silvamafalda966-svg/Strawberry_car/Core/Src/main.c

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
/* Includes ------------------------------------------------------------------*/
#include "main.h"
#include "cmsis_os.h"
#include "i2c.h"
#include "tim.h"
#include "usart.h"
#include "gpio.h"

/* USER CODE BEGIN Includes */
#include "bsp_motor.h"
#include "pid.h"
#include "chassis.h"
/* USER CODE END Includes */


/* USER CODE BEGIN PV */
extern uint8_t rx_byte;    // USART1 RX byte
extern uint8_t rx_byte_bt; // UART4 蓝牙 RX byte

/* USER CODE END PV */

void SystemClock_Config(void);
void MX_FREERTOS_Init(void);
/**
  * @brief  The application entry point.
  * @retval int
  */
int main(void)
{

  /* MCU Configuration--------------------------------------------------------*/

  /* Reset of all peripherals, Initializes the Flash interface and the Systick. */
  HAL_Init();

  /* Configure the system clock */
  SystemClock_Config();

  /* Initialize all configured peripherals */
  MX_GPIO_Init();
  MX_I2C1_Init();
  MX_I2C2_Init();
  MX_TIM1_Init();
  MX_TIM2_Init();
  MX_TIM3_Init();
  MX_TIM4_Init();
  MX_TIM5_Init();
  MX_TIM9_Init();
  MX_USART2_UART_Init();
  MX_TIM8_Init();
  MX_TIM6_Init();
  MX_USART1_UART_Init();
  MX_UART4_UART_Init();   // 蓝牙 RX (PC11)
  MX_UART5_UART_Init();   // 蓝牙 TX (PC12)
  /* USER CODE BEGIN 2 */

  // 1. 唤醒 PWM 动力系统
  Motor_Init();
  PID_Init();
  Chassis_Init();
  // 2. 唤醒 四路编码器测速系统
  HAL_TIM_Encoder_Start(&htim5, TIM_CHANNEL_ALL); // 左前 (FL)
  HAL_TIM_Encoder_Start(&htim4, TIM_CHANNEL_ALL); // 左后 (BL)
  HAL_TIM_Encoder_Start(&htim2, TIM_CHANNEL_ALL); // 右前 (FR)
  HAL_TIM_Encoder_Start(&htim8, TIM_CHANNEL_ALL); // 右后 (BR)
HAL_UART_Receive_IT(&huart1, &rx_byte, 1); // USART1 = VOFA+ USB 调试指令通道
HAL_UART_Receive_IT(&huart4, &rx_byte_bt, 1); // UART4 = 蓝牙指令通道
  /* USER CODE END 2 */

  /* Call init function for freertos objects (in cmsis_os2.c) */
  MX_FREERTOS_Init();

  /* Start scheduler */
  osKernelStart();

  /* We should never get here as control is now taken by the scheduler */

  /* Infinite loop */
  /* USER CODE BEGIN WHILE */
  
  while (1)
  {
    /* USER CODE END WHILE */

    /* USER CODE BEGIN 3 */
  }
  /* USER CODE END 3 */
}

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
/**
  * @brief  Period elapsed callback in non blocking mode
  * @note   This function is called  when TIM7 interrupt took place, inside
  * HAL_TIM_IRQHandler(). It makes a direct call to HAL_IncTick() to increment
  * a global variable "uwTick" used as application time base.
  * @param  htim : TIM handle
  * @retval None
  */
void HAL_TIM_PeriodElapsedCallback(TIM_HandleTypeDef *htim)
{
  if (htim->Instance == TIM7)
  {
    HAL_IncTick();
  }
}

/**
  * @brief  This function is executed in case of error occurrence.
  * @retval None
  */
void Error_Handler(void)
{
  /* USER CODE BEGIN Error_Handler_Debug */
  /* User can add his own implementation to report the HAL error return state */
  __disable_irq();
  while (1)
  {
  }
  /* USER CODE END Error_Handler_Debug */
}
#ifdef USE_FULL_ASSERT
/**
  * @brief  Reports the name of the source file and the source line number
  *         where the assert_param error has occurred.
  * @param  file: pointer to the source file name
  * @param  line: assert_param error line source number
  * @retval None
  */
void assert_failed(uint8_t *file, uint32_t line)
{
  /* USER CODE BEGIN 6 */
  /* User can add his own implementation to report the file name and line number,
     ex: printf("Wrong parameters value: file %s on line %d\r\n", file, line) */
  /* USER CODE END 6 */
}
#endif /* USE_FULL_ASSERT */
