silvamafalda966-svg/Strawberry_car/BSP/Inc/oledfont.h

#ifndef __OLEDFONT_H
#define __OLEDFONT_H

/* ── 中文计数（extern 声明也需要，放最前面） ── */
#define HZK16_COUNT 34

#ifdef OLEDFONT_DEFINE
/* ═════════════════════════════════════════════════
   以下为实际数据定义，仅 oled.c (定义 OLEDFONT_DEFINE) 编译
   ═════════════════════════════════════════════════ */

/* 6x8 ASCII font */
const unsigned char asc2_0806[][6] = {
    {0x00,0x00,0x00,0x00,0x00,0x00},// sp
    {0x00,0x00,0x00,0x2F,0x00,0x00},// !
    {0x00,0x00,0x07,0x00,0x07,0x00},// q2
    {0x00,0x14,0x7F,0x14,0x7F,0x14},// #
    {0x00,0x24,0x2A,0x7F,0x2A,0x12},// $
    {0x00,0x62,0x64,0x08,0x13,0x23},// %
    {0x00,0x36,0x49,0x55,0x22,0x50},// &
    {0x00,0x00,0x05,0x03,0x00,0x00},// '
    {0x00,0x00,0x1C,0x22,0x41,0x00},// (
    {0x00,0x00,0x41,0x22,0x1C,0x00},// )
    {0x00,0x14,0x08,0x3E,0x08,0x14},// *
    {0x00,0x08,0x08,0x3E,0x08,0x08},// +
    {0x00,0x00,0x00,0xA0,0x60,0x00},// ,
    {0x00,0x08,0x08,0x08,0x08,0x08},// -
    {0x00,0x00,0x60,0x60,0x00,0x00},// .
    {0x00,0x20,0x10,0x08,0x04,0x02},// /
    {0x00,0x3E,0x51,0x49,0x45,0x3E},// 0
    {0x00,0x00,0x42,0x7F,0x40,0x00},// 1
    {0x00,0x42,0x61,0x51,0x49,0x46},// 2
    {0x00,0x21,0x41,0x45,0x4B,0x31},// 3
    {0x00,0x18,0x14,0x12,0x7F,0x10},// 4
    {0x00,0x27,0x45,0x45,0x45,0x39},// 5
    {0x00,0x3C,0x4A,0x49,0x49,0x30},// 6
    {0x00,0x01,0x71,0x09,0x05,0x03},// 7
    {0x00,0x36,0x49,0x49,0x49,0x36},// 8
    {0x00,0x06,0x49,0x49,0x29,0x1E},// 9
    {0x00,0x00,0x36,0x36,0x00,0x00},// :
    {0x00,0x00,0x56,0x36,0x00,0x00},// ;
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
    HZK_22,  /* 速 */
    HZK_23,  /* 度 */
    HZK_24,  /* 已 */
    HZK_25,  /* 连 */
    HZK_26,  /* 未 */
    HZK_27,  /* 失 */
    HZK_28,  /* 败 */
    HZK_29,  /* 扫 */
    HZK_30,  /* 描 */
    HZK_31,  /* 区 */
    HZK_32,  /* 域 */
    HZK_33,  /* 熟 */
};

#endif /* __OLEDFONT_H */
