silvamafalda966-svg/Strawberry_car/(commit log)

2026-05-29 Initial commit: Day 1-2 baseline
    Four-wheel PID closed loop (Kp=0.35, Ki=0.06, Kd=0.04), encoder reading,
    K210 8-byte frame parser, VOFA+ USART1 debug, USART2 interrupt mode.
    Stall protection, speed ramp, parking lock strategy.
    Task_Sensor and Task_OLED are stubs.
2026-05-29 Phase 1: state machine skeleton + Chassis_Move API
    New files:
    - BSP/Inc/chassis.h: 10-state enum, SensorData_t, VisionData_t,
    StateDescriptor_t, 6 Chassis_Move API declarations, global variables
    - BSP/Src/chassis.c: descriptor table, Chassis_Move API implementations,
    VOFA+ M command parser, Chassis_Init(), state machine dispatcher.
    DEBUG state fully functional, IDLE state functional, 8 stubs with
    safe (Chassis_Stop) entries for Phase 2-4.
    Modified files:
    - freertos.c: main loop restructured (VOFA+ parse → encoder → vision
    queue → sensor mutex → emergency stop → state machine → PID×4 →
    VOFA+ upload). Task_Sensor implemented (IR read + emergency flag).
    K210 queue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
2026-05-29 Fix: add chassis.c to Keil project file
    Build error: L6218E undefined symbol for Chassis_Init, Chassis_Stop,
    Chassis_VOFA_Parse, Chassis_StateMachine_Run, g_chassis_state,
    g_emergency_stop — chassis.c was not in the project file.
2026-05-29 Fix: M command mapping (M0→IDLE, M1→LINE_FOLLOW, ..., M8→FINISH)
    Previously M0 mapped to STATE_DEBUG (enum=0), so hitting M0 while
    already in DEBUG was a no-op. Now matches the scheme document:
    MD→DEBUG, M0→IDLE, M1→LINE_FOLLOW, ..., M8→FINISH.
2026-05-29 Phase 1 fix: vision queue gate + LINE_FOLLOW entry cleanup
    - freertos.c: only read K210 queue when state is LINE_FOLLOW,
    BREAKAWAY, or VISUAL_APPROACH (not OBSTACLE/BLIND_RETURN etc.)
    - chassis.c entry_line_follow: MoveForward(0.3) + drain K210 queue
    to prevent stale frames triggering false detections
2026-06-02 Phase 2: 避障尾段重构 + BR PID调参 + 阶段间速度归零刹车
    - OB_TURN_ALIGN(90°)+OB_FIND_LINE(自旋) → OB_TURN_45(45°)+OB_FORWARD_TO_LINE(直行斜插上线)
    - 新增 TURN45_TOTAL_ENC/OB_FWD_TO_LINE_CM 宏
    - 阶段间刹车改为检测四轮 Actual 速度全部 <0.03m/s 才放行，最长等1s兜底
    - BR 右后轮 PID: Kp=0.75 Ki=0.07 Kd=0.01
2026-06-02 Phase 2 测试完成: 避障尾段优化 + 空转调试宏 + BR PID调参
    - 阶段间刹车改为检测四轮速度<0.03m/s放行，1s超时兜底
    - BR PID: Kp=0.55 Ki=0.05 Kd=0.05
    - 新增 ENABLE_ULTRASONIC 宏(空转测试时=0禁用超声波紧急刹车)
    - 新增 FORCE_STRAIGHT 宏(空转时=1强制LINE_FOLLOW纯直行，忽略悬空红外误读)
    - 根因定位: 红外悬空GPIO随机电平→LINE_FOLLOW误判线位置→不对称Target(0.45vs0.16)
    - VOFA+恢复原8通道格式(4轮速度+IR+黑点数+编码器+帧尾)
    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
2026-06-06 Day 6: 红外+超声波硬件接入完成
    - 八路红外巡线模块 IO 模式验证通过，PE0~PE7
    - HC-SR04 超声波改用 TIM3 CH4 输入捕获中断，零阻塞
    - 急停逻辑修复：距离>15cm 自动清零，仅 LINE_FOLLOW 触发
    - ENABLE_ULTRASONIC=1, FORCE_STRAIGHT=0 恢复正常模式
2026-06-11 Day 7: OLED SSD1315 I2C接入完成 - 中文字库+容错+蜂鸣心跳
2026-06-11 Day 7: 补充OLED驱动源文件(上一提交遗漏)
2026-06-11 Phase 3: v5草莓检测链完整实现 - 定长24B DMA+IDLE + 双轴伺服 + 固定窗口扫描
2026-06-13 feat: PID系统扫参 + BR前馈补偿 + EMA滤波 + 积分抗饱和
    三轮 PID: Kp=0.20 Ki=0.08 Kd=0.02 (超调0.9% 纹波0.0015)
    BR PID: Kp=0.35 Ki=0.08 Kd=0.10 + FF=40 (平台期95→35ms)
    EMA 滤波: α=0.3 四轮低通降噪
    积分抗饱和: 输出饱和时抑制同向I项蓄力
    F/L 命令: 运行时调前馈/滤波系数
    新增 tools/pid_tuner.py: 自动扫参脚本
2026-07-08 feat: V2 岔路采摘策略 + Zone Demo + 赛道实测参数校准
    - 状态机精简 15→10 状态（V1视觉链→V2岔路方案）
    - 黑胶带岔路检测：6路IR全黑×3帧消抖，十字标记
    - K210 多目标排序决策：红>绿，大>小，近>远
    - Zone Demo 全链路：Z:命令→编码器匹配→判定→返程
    - 赛道实测校准：ENC_PER_CM=2789, TURN90=199700, TURN180=399400
    - IR 传感器极性修正（TCRT5000+LM393 输出翻转）
    - 草莓区内侧策略（JUNCTION_SIDE=-1 左转进岔）
    - 避障参数实测调整（OB_BACK_CM=5, OB_FORWARD_CM=47）
    - 五指令文本协议集：S:/D:/C:/K:/Z:
    - OLED 中文字库扩展（区/域/熟）+ 区域信息面板
    - Bug修复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
2026-10-15 chore: 移除构建产物与内部文档，补全 .gitignore
    - 移除 6 个 Keil 构建产物（.axf/.hex/.map/.htm/.dep/.iex），仓库体积显著减小
    - 移除 docs/（答辩准备、交付交接、视频脚本等内部材料，不适合公开）
    - .gitignore 改为按模式排除 MDK-ARM 全部产物，保留 .uvprojx/.sct/startup.s 三个构建必需文件
2026-10-15 feat: MPU6050 陀螺仪集成 + K210 视觉模型与部署脚本 + 项目文档
    固件
    - 新增 BSP/{Inc,Src}/mpu6050.{c,h}：硬件零偏寄存器 + FIFO 校准 + 在线零偏 + EMA 低通
    - 陀螺仪迁至独立 I2C1，与 OLED(I2C2) 物理隔离，解决刷屏时姿态数据跳变
    - 状态机扩展至 11 状态：岔路采摘（进入/巡线/判定/倒车）+ Zone 返程
    - PID 增补积分抗饱和、测速 EMA 滤波、目标斜坡、BR 摩擦前馈、堵转保护
    视觉
    - 新增 k210/：YOLOv2 模型（z3 部署版 + z4 对照）、部署脚本、协议与迭代文档
    - 24B 定长视觉帧：5 目标槽 + XOR 校验，按 X 排序便于下位机顺序处理
    - 模型经 4 轮迭代，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
